Slowlybomb/T4-GroupProject/report/Gondalier_report.md

<script>
MathJax = { tex: { inlineMath: [['$','$']] } };
</script>
<script src="https://cdn.jsdelivr.net/npm/mathjax@3/es5/tex-chtml.js"></script>

# Gondolier
An Open Source Rowing Monitor
#### Group 4

Gondolier Logo

#### Group Members
- Hugo Guenebaut
- Emin Aksoyg
- Nixie
- Hleb Slyusar
- David Fresno
- Mark Cannavan

**Preface**

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

**Summary**

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

**History and Motivation**

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

**Context and Goals**

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

**System Overview**

At a high level Gondolier consists of:

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

**Architecture and Components**

This section describes components and their responsibilities, and how they interact.

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

2. Firmware (high level)

The firmware organizes functionality into modules:

- `accelerometer.h` \- handles IMU initialization, configuration and provides a ring buffer of recent acceleration samples.  
- `model.h` / `model_data.h` \- contain the TensorFlow Lite Micro model and inference integration code.  
- `Display.h` \- UI primitives for the on-boat display: main screen, metric updates, and minimal menus.  
- `networking.h` \- BLE advertisement, GATT services, and a simple protocol to upload sessions to the phone app.  
- `embedded-code.ino` \- application entrypoint, task orchestration, and state machine for session lifecycle.  
    
3. Machine learning model  
   The stroke detection model is trained offline on labeled IMU windows and exported to TFLite (`model.tflite`). At runtime we run a fixed-length sliding window of accelerometer magnitude through the TFLite Micro interpreter. The model outputs a probability (stroke / not-stroke) and the firmware applies a detection algorithm (threshold \+ debounce) to produce discrete stroke events.  

**Electronic Assembly:**

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

Simplified Schematic of the rowing tracker  
Simplified schematic of the rowing tracker

Breakout image of the electronics:

Image of the full electronics stack:  
**Design Decisions and Trade-offs**

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

**Obtaining Training Data**

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

Unprocessed z axis accelerometer data  
Unprocessed z axis accelerometer data
Because we knew that rowers would want to tilt the device at different angles so they could view the screen in boats with different designs, we had to process the data in a way that would be totally agnostic to device orientation. To achieve this, we used simple trigonometry. Obtaining the magnitude of the Y and Z axes, where the data is present, turned it into a vector of acceleration that would not change depending on orientation. 

$$
\vec{v} = \sqrt{Y^2 + Z^2}
$$

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

Noise signal before rolling average  
Noise signal before rolling average
Blue line inside orange shows the processed signal compared to orange noisy signal  
Blue line inside orange shows the processed signal compared to orange noisy signal
Lastly to remove gravitation anomalies, another rolling average was done but with a sample window size of 500, this acted as a high pass filter allowing the stroke data to pass through but not changes in the tilt of the boat

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

30 seconds of processed data showing 9 strokes  
30 seconds of processed data showing 9 strokes

- Creating stroke and non stroke training windows: Now that the data is cleaned and processed we had to decide how to best package the data to feed into the neural network, we tried a variety of methods for this, where we struggled was finding non stroke data, typically once on the water, Sally will row stroke after stroke until she is done with little rest time so to get non stroke data is very difficult, i created a python script that looked for peaks over a certain height, it labelled these peaks and then created windows across the whole dataset, overlapping with an offset of 1 second, the % of the stroke in each window was labelled based on where in the stroke the spike occurred and then a graph of each stroke was presented by the code to be manually approved or rejected, all windows that had less than 70% of a stroke as labelled as not a stroke. In the end, 400 windows were given to the model to train on, 300 stroke windows and 100 non stroke windows. This was a smaller dataset than we had wanted to work on but it still functioned well. This was the 8th different way we tried to window the data, it was difficult and involved a lot of trial and error and any attempt to use AI on this task threw us awry as this has never been attempted before publicly so there is no data online  

  Manual review of stroke data  
Manual review of stroke data
  Automated review of stroke data of entire 40 rowing session  
Automated review of stroke data of entire 40 rowing session

**Data Flow and Algorithms**

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

5. Event generation

6. Sync: When a session is complete, the user can request the session over 
   bluetooth, and the device will stream metadata and stroke timestamps to the phone app for storage and analysis.

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

2. Connection: The client connects and performs the GATT discovery process

3. Requests: The client writes `GET_SESSION` to the command characteristic

4. Data Transfer: The device sets status to `SENDING` and notifies packets 
   on the data characteristic

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

6. On a disconnect, the device resumes advertising automatically

Time Diagram of a typical Gondolier BLE Connection

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

A single custom service is exposed:

| Service UUID | 12345678-1234-1234-1234-123456789abc |
|---|---|

And three characteristics can be found in the GATT profile:

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

Structure of a data packet

**Firmware Structure and Files**

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

Build, Flashing, and Development

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

**Development Tips**

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

**Testing and Evaluation**

Unit testing on-device is limited, but key techniques used:

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

**Performance and Resource Usage**

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

**Security, Privacy, and Safety**

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

**Future Work and Open Questions**

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

**Appendix A \- File map and responsibilities**

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

**Appendix B \- How stroke detection works (algorithm)**

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

**Appendix C \- Contributors and references**

Contributors:

- Hugo Guenebaut \- Embedded systems lead  
- Emin Aksoy \- Machine learning engineer   
- Nixie \- Embedded UI designer  
- Mark \- Communications and radio engineer  
- 

References:

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
