Slowlybomb/T4-GroupProject/report/Gondalier_report.html

# Gondolier

An Open Source Rowing Monitor

## Group 4

Project Logo Gondolier Logo

### Group Members

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

## Preface

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

### Summary

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

### History and Motivation

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

### Context and Goals

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

### System Overview

At a high level Gondolier consists of:

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

## Architecture and Components

This section describes components and their responsibilities, and how they interact.

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

The firmware organizes functionality into modules:

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

### Electronic Assembly:

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

Simplified Schematic of the rowing tracker
Simplified schematic of the rowing tracker

Breakout image of the electronics:

Image of the full electronics stack:

### Design Decisions and Trade-offs

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

### Obtaining Training Data

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

Unprocessed z axis accelerometer data
Unprocessed z axis accelerometer data Because we knew that rowers would want to tilt the device at different angles so they could view the screen in boats with different designs, we had to process the data in a way that would be totally agnostic to device orientation. To achieve this, we used simple trigonometry. Obtaining the magnitude of the Y and Z axes, where the data is present, turned it into a vector of acceleration that would not change depending on orientation.

$$ \vec{v} = \sqrt{Y^2 + Z^2} $$

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

Noise signal before rolling average
Noise signal before rolling average

Blue line inside orange shows the processed signal compared to orange noisy signal
Blue line inside orange shows the processed signal compared to orange noisy signal

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

30 seconds of processed data showing 9 strokes
30 seconds of processed data showing 9 strokes

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

Manual review of stroke data
Manual review of stroke data

Automated review of stroke data of entire 40 rowing session
Automated review of stroke data of entire 40 rowing session

### Data Flow and Algorithms

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

#### Firmware Structure and Files

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

### Build, Flashing, and Development

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

#### Development Tips

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

#### Testing and Evaluation

Unit testing on-device is limited, but key techniques used:

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

#### Performance and Resource Usage

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

#### Security, Privacy, and Safety**

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

### Future Work and Open Questions

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

## Display

### Technical Specification

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

### Design Choices

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

Initial Display UI Prototype After review and feedback, this screen layout proved suboptimal. The most important piece of information on the screen for a rower will be the strokes per minute. Even though it is displayed as the biggest element, it still might not be clear enough for the number to be glanced at from a distance, or if the screen gets wet. Additionally, the font chosen proved not legible enough, especially since the same font was used for the text and the numbers. This led to many rough pixelated edges, making it harder to see the information needed.

The final UI screen builds upon the feedback received in all aspects.

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

Final Iteration of Display UI

### Tools, Functions and Workflow

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

Physical access to the board was limited, so to test out the UI, the code, and to ensure everything displayed properly, an esp32 emulator website wokwi.com was used. This website allowed us to work in parallel and then sync our work together using git.

Final Iteration of Display UI

### UI and Logo

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

Final Iteration of Display UI

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

## API, Database and CI/CD

### Preface

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

Decision and trade-off. we kept this subsystem focused on the implemented MVP rather than a larger platform design. That gave us a small and understandable backend surface that supported the app and report requirements without spending project time on infrastructure we did not need to demo.

### System Architecture

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

Architecture figure: Architecture figure

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

Decision and trade-off. This architecture deliberately prefers managed services over a fully self-hosted stack. The trade-off is less control over every layer, but in return we gained faster delivery, simpler environment setup, and tighter integration between auth, storage, and database security.

### API Design and Implementation

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

Decision and trade-off. I chose explicit handler validation and small repository methods instead of a more abstract service stack. The code is more repetitive, but every route's behaviour, validation rule, and failure mode is easy to trace, which was a better fit for a project that needed clarity more than abstraction.

### Authentication, Authorization, and Storage Security

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

Decision and trade-off. Manual JWKS verification required more code than using a shared secret or opaque auth proxy, but it kept the API independent, avoided storing a JWT signing secret in the service, and made the trust boundary explicit. The trade-off is that security logic has to be implemented carefully, which is why both middleware checks and database policies were used.

### Database Schema and Migration Decisions

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

The migration history shows how the schema evolved with the product:

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

Current database version: 5

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

Decision and trade-off. I chose a strongly constrained relational schema instead of storing most app state in loosely structured JSON documents. That makes migrations and schema changes more deliberate, but it gives clearer integrity guarantees and far simpler query logic for feeds, follows, and derived workout summaries.

### Database Automation and Derived Metrics

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

Decision and trade-off. Database-side derivation makes reads simpler and keeps client-visible workout values consistent, but it pushes more logic into migrations and trigger functions. I accepted that trade-off because the calculations are tightly coupled to persisted rowing data and are safer when enforced centrally rather than duplicated across clients.

### CI/CD, Deployment, and Local Development

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

Decision and trade-off. I prioritised a small operational surface: one Makefile, GitHub Actions for validation, and a deploy hook for release. The trade-off is that the deployment process is not a sophisticated release pipeline, but it is easy to understand, easy to troubleshoot, and appropriate for an MVP and demonstration environment.

### Testing, Trade-offs, and Future Work

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

Decision and trade-off. I treated testing and delivery as part of the product rather than as cleanup work at the end. The trade-off is that some future-facing features remain only partially integrated, but the implemented backend behaviour is better specified, better tested, and easier for another engineer to continue from.

## Appendixes

### Appendix A - File map and responsibilities

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

### Appendix B - How stroke detection works (algorithm)

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

### Appendix C - Contributors and references

Contributors:

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

### Appendix D - Backend file map and responsibilities

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

### Appendix E - Implemented API route reference

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

### Appendix F - Database migration map

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

### Appendix G - Operations and CI/CD quick reference

Make targets:

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

Environment variables:

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

Workflow summary:

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

### References

- TensorFlow Lite Micro documentation - https://www.tensorflow.org/lite/micro
- ESP32-S3 datasheet - https://documentation.espressif.com/esp32-s3_datasheet_en.pdf
- QMI8658 datasheet - https://qstcorp.com/upload/pdf/202202/QMI8658C%20datasheet%20rev%200.9.pdf
- ILI9431 datasheet - https://cdn-shop.adafruit.com/datasheets/ILI9341.pdf
