Slowlybomb/T4-GroupProject/app/flutter_app/assets/img/dummy-pp.png

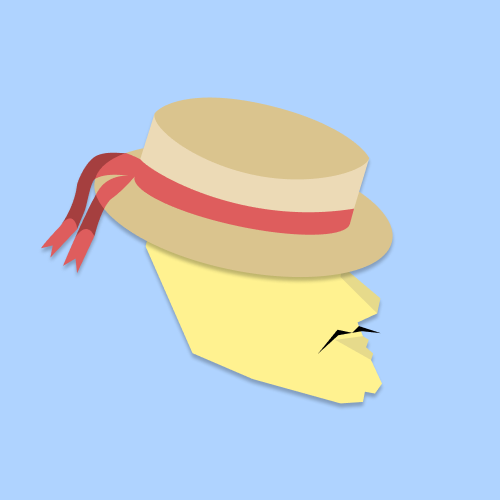
app/flutter_app/assets/img/dummy-pp.png
