Slowlybomb/T4-GroupProject/report/post.jpg

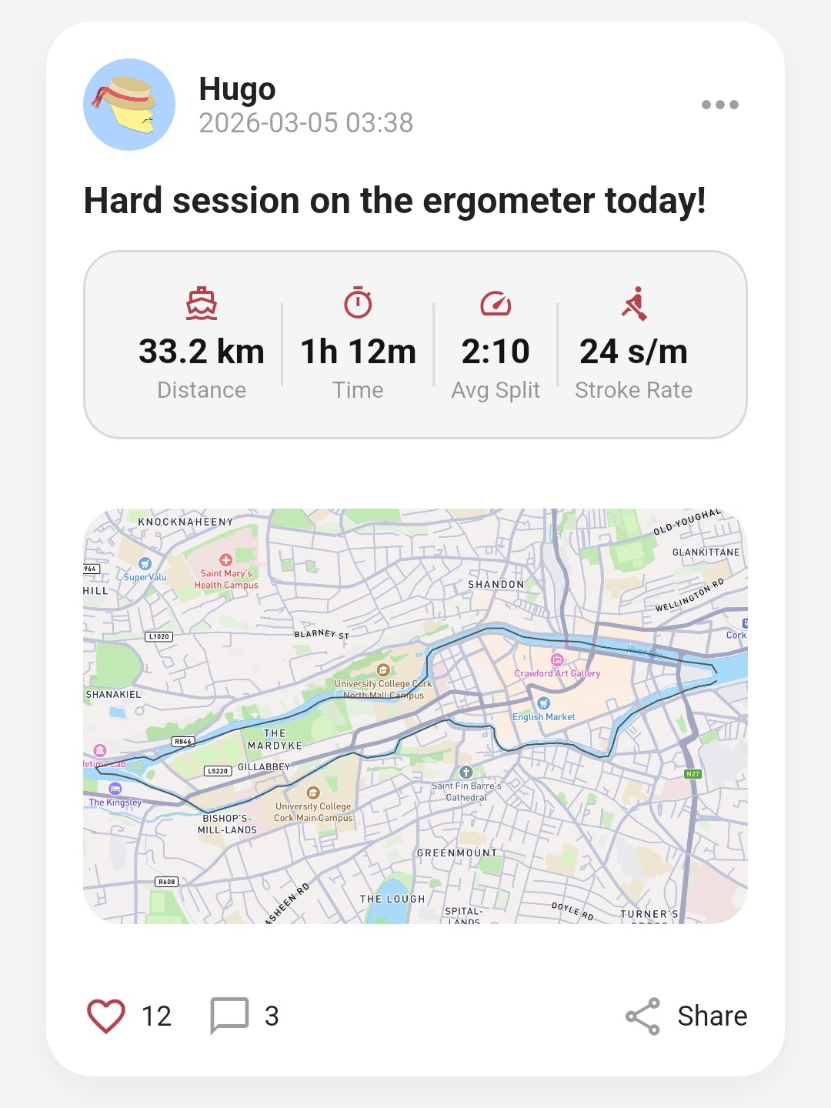
report/post.jpg
