Slowlybomb/T4-GroupProject/report/profile.jpg

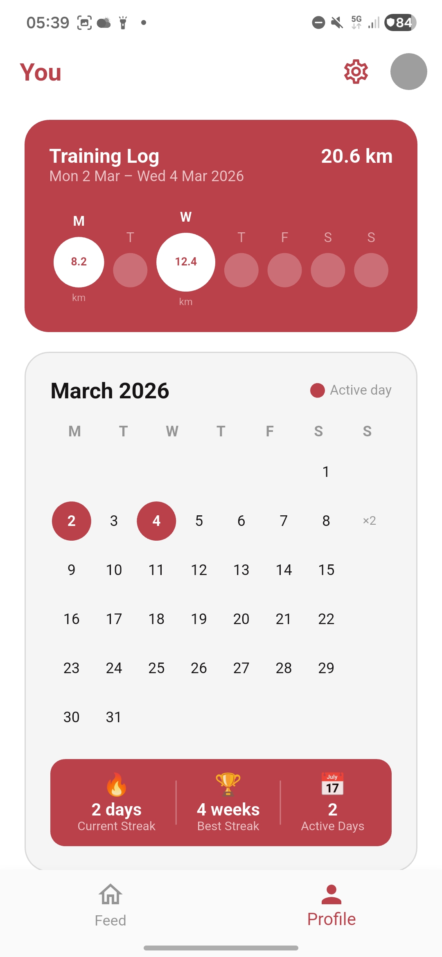
report/profile.jpg
