Slowlybomb/T4-GroupProject/report/t4_time_diagram.png

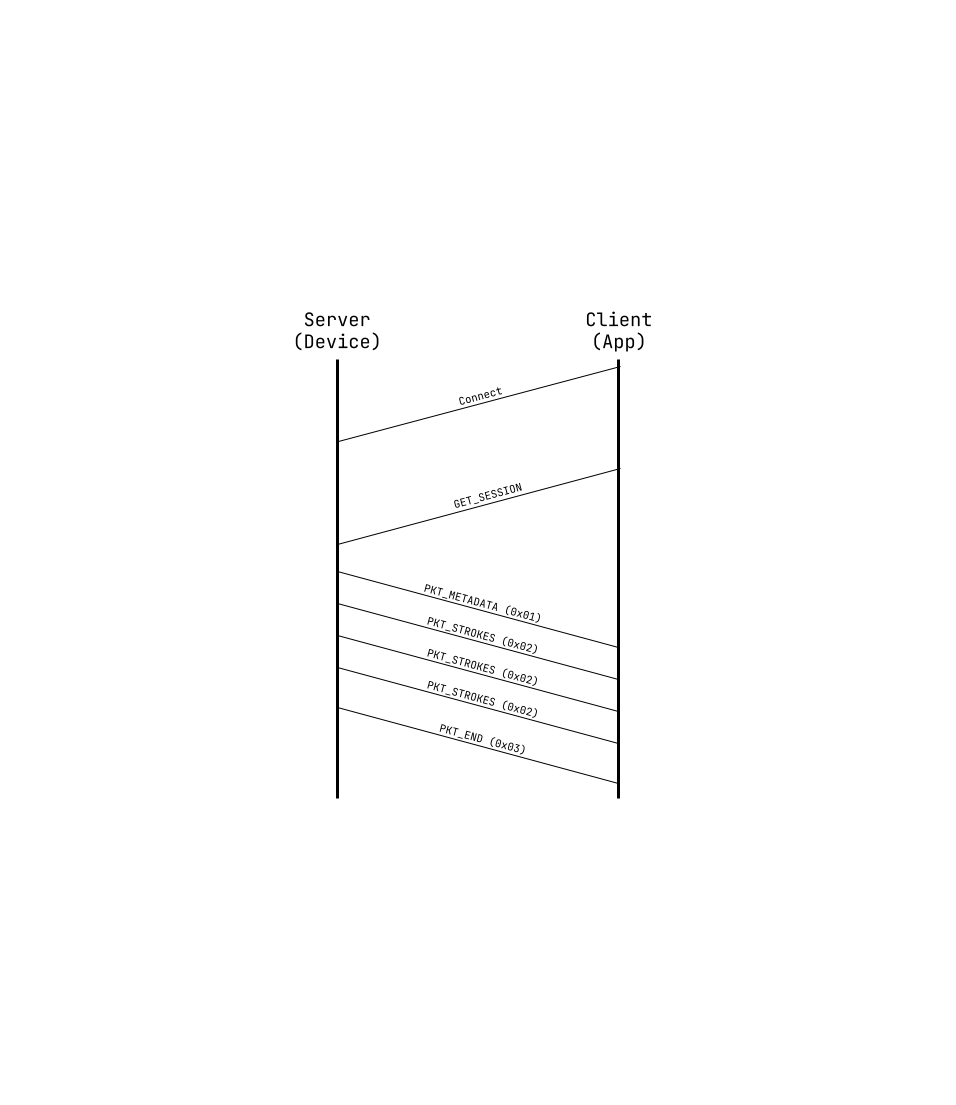
report/t4_time_diagram.png
