Slowlybomb/T4-GroupProject/Embedded_code/embedded-code/Display.h

// ILI9341 display and Gondolier rowing UI
//
// controlls the MCU UI, updates screen, initiates screen and sends split, elapsed and spm data to the screen for rendering

#pragma once
#include <Adafruit_ILI9341.h>
#include <Adafruit_GFX.h>
#include <Fonts/Org_01.h>

// Pins
#define TFT_CS    14
#define TFT_DC    18
#define TFT_RST   8
#define TFT_MOSI  11
#define TFT_CLK   12
//#define TFT_MISO  19
#define TFT_BL    17


// Colours 
#define C_WHITE  0xFFFF
#define C_BLACK  0x0000
#define C_GREEN  0x07E0
#define C_RED    0xF800
#define C_BLUE   0x001F

//Icon bitmaps
#ifndef ICONS_H
#define ICONS_H

// 24x13 battery icon
static const unsigned char image_battery_full_bits[] PROGMEM = {
  0xFF, 0xFF, 0xFF, 0x80, 0x00, 0x01, 0x80, 0x00, 0x01, 0x9F, 0xFF, 0xE1,
  0x9F, 0xFF, 0xE1, 0x9F, 0xFF, 0xE1, 0x9F, 0xFF, 0xE1, 0x9F, 0xFF, 0xE1,
  0x9F, 0xFF, 0xE1, 0x9F, 0xFF, 0xE1, 0x80, 0x00, 0x01, 0x80, 0x00, 0x01,
  0xFF, 0xFF, 0xFF
};

// 19x16 wifi icon
static const unsigned char image_wifi_bits[] PROGMEM = {
  0x07, 0xC0, 0x00, 0x1F, 0xF0, 0x00, 0x7C, 0x3C, 0x00, 0xF0, 0x0F, 0x00,
  0xC3, 0xC3, 0x00, 0x0F, 0xF0, 0x00, 0x3C, 0x3C, 0x00, 0x00, 0x00, 0x00,
  0x07, 0xE0, 0x00, 0x1F, 0xF8, 0x00, 0x18, 0x18, 0x00, 0x00, 0x00, 0x00,
  0x01, 0x80, 0x00, 0x01, 0x80, 0x00, 0x00, 0x00, 0x00, 0x00, 0x00, 0x00
};

static const unsigned char PROGMEM image_gondolier_icon_bits[] = {0x00,0x00,0x00,0x00,0x00,0x00,0x00,0x00,0x00,0x00,0x00,0x00,0x00,0x00,0x00,0x00,0x00,0x00,0x00,0x00,0x00,0x00,0x00,0x00,0x00,0x00,0x00,0x00,0x00,0x00,0x00,0x00,0x00,0x00,0x00,0x00,0x00,0x00,0x00,0x00,0x00,0x00,0x00,0x00,0x00,0x00,0x00,0x00,0x00,0x00,0x00,0x00,0x00,0x00,0x00,0x00,0x00,0x00,0x00,0x00,0x00,0x00,0x00,0x00,0x00,0x00,0x00,0x00,0x00,0x00,0x00,0x00,0x00,0x00,0x00,0x00,0x00,0x00,0x00,0x00,0x00,0x00,0x00,0x00,0x00,0x00,0x00,0x00,0x00,0x00,0x00,0x00,0x00,0x00,0x00,0x00,0x00,0x00,0x00,0x00,0x00,0x00,0x00,0x00,0x00,0x00,0x00,0x00,0x00,0x00,0x00,0x00,0x00,0x00,0x00,0x00,0x00,0x00,0x00,0x00,0x00,0x00,0x00,0x00,0x00,0x00,0x00,0x00,0x00,0x00,0x00,0x00,0x00,0x00,0x00,0x00,0x00,0x00,0x00,0x00,0x00,0x00,0x00,0x00,0x00,0x00,0x00,0x00,0x00,0x00,0x00,0x00,0x00,0x00,0x00,0x00,0x00,0x00,0x00,0x00,0x00,0x00,0x00,0x00,0x00,0x00,0x00,0x00,0x00,0x00,0x00,0x00,0x00,0x00,0x00,0x00,0x00,0x00,0x00,0x00,0x00,0x00,0x00,0x00,0x00,0x00,0x00,0x00,0x00,0x00,0x00,0x00,0x00,0x00,0x00,0x00,0x00,0x00,0x00,0x00,0x00,0x00,0x00,0x00,0x00,0x00,0x00,0x00,0x00,0x00,0x00,0x00,0x00,0x00,0x00,0x00,0x00,0x00,0x00,0x00,0x00,0x00,0x00,0x00,0x00,0x00,0x00,0x00,0x00,0x00,0x00,0x00,0x00,0x00,0x00,0x00,0x00,0x00,0x00,0x00,0x00,0x00,0x00,0x00,0x00,0x00,0x00,0x00,0x00,0x00,0x00,0x00,0x00,0x00,0x00,0x00,0x00,0x00,0x00,0x00,0x00,0x00,0x00,0x00,0x00,0x00,0x00,0x00,0x00,0x00,0x00,0x00,0x00,0x00,0x00,0x00,0x00,0x00,0x00,0x00,0x00,0x00,0x00,0x00,0x00,0x00,0x00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
,0x00,0x00,0x00,0x00,0x00,0x00,0x00,0x00,0x00,0x00,0x00,0x00,0x00,0x00,0x00,0x00,0x00,0x00,0x00,0x00,0x00,0x00,0x00,0x00,0x00,0x00,0x00,0x00,0x00,0x00,0x00,0x00,0x00,0x00,0x00,0x00,0x00,0x00,0x00,0x00,0x00,0x00,0x00,0x00,0x00,0x00,0x00,0x00,0x00,0x00,0x00,0x00,0x00,0x00,0x00,0x00,0x00,0x00,0x00,0x00,0x00,0x00,0x00,0x00,0x00,0x00,0x00,0x00,0x00,0x00,0x00,0x00,0x00,0x00,0x00,0x00,0x00,0x00,0x00,0x00,0x00,0x00,0x00,0x00,0x00,0x00,0x00,0x00,0x00,0x00,0x00,0x00,0x00,0x00,0x00,0x00,0x00,0x00,0x00,0x00,0x00,0x00,0x00,0x00,0x00,0x00,0x00,0x00,0x00,0x00,0x00,0x00,0x00,0x00,0x00,0x00,0x00,0x00,0x00,0x00,0x00,0x00,0x00,0x00,0x00,0x00,0x00,0x00,0x00,0x00,0x00,0x00,0x00};

#endif // ICONS_H

// Main UI
// initiate the full UI
void show_ui(Adafruit_ILI9341& tft) {
  tft.drawBitmap(290, 9, image_battery_full_bits, 24, 13, C_WHITE);
  tft.drawLine(1,   29,  319, 29,  C_WHITE);  // Header separator
  tft.drawLine(0,   169, 319, 169, C_WHITE);  // Stats separator
  tft.drawLine(0,   239, 318, 239, C_WHITE);  // Bottom border
  tft.drawLine(319, 0,   319, 239, C_WHITE);  // Right border
  tft.drawLine(0,   0,   319, 0,   C_WHITE);  // Top border
  tft.drawLine(0,   0,   0,   239, C_WHITE);  // Left border

  // Stroke count
  tft.setTextColor(C_WHITE);
  tft.setFont(&Org_01);
  tft.setTextSize(20);
  tft.setTextWrap(false);
  tft.setCursor(108, 126);
  tft.print("0");

  // Split time
  tft.setTextSize(4);
  tft.setCursor(22, 205);
  tft.print("0:00");

  // Strokes per minute
  tft.setFont(nullptr);
  tft.setTextSize(2);
  tft.setCursor(276, 150);
  tft.print("S/M");

  // Elapsed time
  tft.setFont(&Org_01);
  tft.setTextSize(3);
  tft.setCursor(186, 202);
  tft.print("00:00:00");

  // labels
  tft.setFont(nullptr);
  tft.setTextSize(2);
  tft.setCursor(218, 218);
  tft.print("Elapsed");
  tft.setCursor(23, 219);
  tft.print("split");

  // Header left — stroke rate
  tft.setFont(&Org_01);
  tft.setCursor(13, 20);
  tft.print("0:00");

  // WiFi icon
  tft.drawBitmap(258, 7, image_wifi_bits, 19, 16, C_WHITE);
}

// Splash screen

// Boot logo
void splashscreen(Adafruit_ILI9341& tft) {
  tft.fillScreen(C_BLACK);
  tft.drawBitmap(34, -40, image_gondolier_icon_bits, 262, 240, C_WHITE);
  tft.setTextColor(C_WHITE);
  tft.setFont(nullptr);
  tft.setTextSize(4);
  tft.setTextWrap(false);
  tft.setCursor(55, 203);
  tft.print("Gondolier");
}

// Live data updaters 

void update_timer(Adafruit_ILI9341& tft, const String& time) {
  tft.fillRect(186, 186, 130, 26, C_BLACK);
  tft.setFont(&Org_01);
  tft.setTextSize(3);
  tft.setCursor(186, 202);
  tft.print(time);
}

void update_split(Adafruit_ILI9341& tft, const String& split) {
  tft.fillRect(4, 186, 106, 26, C_BLACK);
  tft.setFont(&Org_01);
  tft.setTextSize(4);
  tft.setCursor(22, 205);
  tft.print(split);
}

// Centers the stroke count based on number of digits
void update_strokes(Adafruit_ILI9341& tft, const String& strokes) {
  tft.fillRect(44, 44, 240, 102, C_BLACK);
  tft.setTextColor(C_WHITE);
  tft.setFont(&Org_01);
  tft.setTextSize(20);

  int len = strokes.length();
  int cursorX = 108;

  if (len == 1) {
    cursorX = (strokes[0] == '1') ? 148 : 108;
  } else if (len == 2) {
    bool d0is1 = (strokes[0] == '1');
    bool d1is1 = (strokes[1] == '1');
    if (d0is1 && d1is1) cursorX = 124;
    else if (d0is1 || d1is1) cursorX = 84;
    else cursorX = 44;
  }

  tft.setCursor(cursorX, 126);
  tft.print(strokes);
}

// Updates strokes, split, and elapsed time together
void update_screen(Adafruit_ILI9341& tft,
                   const String& strokes,
                   const String& split,
                   const String& time) {
  update_strokes(tft, strokes);
  update_split(tft,   split);
  update_timer(tft,   time);
}

// Status overlays

void show_bluetooth_status(Adafruit_ILI9341& tft, bool connected) {
  tft.fillRect(230, 4, 22, 22, C_BLACK);
  tft.setFont(nullptr);
  tft.setTextSize(2);
  tft.setTextColor(connected ? C_GREEN : C_RED);
  tft.setCursor(232, 8);
  tft.print("BT");
}

// Green when connected, white when idle
void show_wifi_status(Adafruit_ILI9341& tft, bool connected) {
  tft.drawBitmap(258, 7, image_wifi_bits, 19, 16, connected ? C_GREEN : C_WHITE);
}

// Progress bar + "Sending data..." message
void show_transfer_progress(Adafruit_ILI9341& tft, int percent) {
  tft.fillRect(10, 80, 300, 40, C_BLACK);
  tft.setFont(nullptr);
  tft.setTextSize(2);
  tft.setTextColor(C_WHITE);
  tft.setCursor(100, 85);
  tft.print("Sending data...");
  // Progress bar
  tft.drawRect(10, 106, 300, 14, C_WHITE);
  int filled = (int)(300.0f * percent / 100.0f);
  tft.fillRect(10, 106, filled, 14, C_GREEN);
}

// Shows a message in the middle of the screen
void show_message(Adafruit_ILI9341& tft, const String& msg, uint16_t colour = C_WHITE) {
  tft.fillRect(10, 80, 300, 60, C_BLACK);
  tft.setFont(nullptr);
  tft.setTextSize(2);
  tft.setTextColor(colour);
  tft.setCursor(10, 100);
  tft.print(msg);
}

// formats time into "HH:MM:SS"
String formatElapsed(uint32_t seconds) {
  uint32_t h = seconds / 3600;
  uint32_t m = (seconds % 3600) / 60;
  uint32_t s = seconds % 60;
  char buf[12];
  snprintf(buf, sizeof(buf), "%02u:%02u:%02u", h, m, s);
  return String(buf);
}

// formats time into "M:SS" (e.g. 135 → "2:15")
String formatSplit(uint32_t splitSeconds) {
  uint32_t m = splitSeconds / 60;
  uint32_t s = splitSeconds % 60;
  char buf[8];
  snprintf(buf, sizeof(buf), "%u:%02u", m, s);
  return String(buf);
}
