Slowlybomb/T4-GroupProject/(commit log)

2026-02-16 feat: Add initial database schema migration files for Supabase
    - Created `000001_initial_schema.up.sql` for setting up the initial database schema including tables for profiles, teams, activities, follows, likes, and comments.
    - Created `000001_initial_schema.down.sql` for rolling back the initial schema.
    - Implemented row-level security policies for activities to manage visibility based on user authentication.
    - Added a trigger to ensure team owners are also members of their teams.
    docs: Update project documentation
    - Revised `App-Plan.md` to reflect the current tech stack and rationale.
    - Enhanced `Checklist.md` with completed tasks and additional details on JWT validation and user sessi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
2026-02-17 Add cache files for various Go modules and update build artifacts
    - Created new cache files for Go build artifacts in the app/api/.cache/go-build directory.
    - Added lock files for dependencies: gin-gonic/gin v1.11.0 and jackc/pgx v5.8.0.
    - Introduced a trim.txt file to track build timestamps.
    - Updated internal cache for godebugs and ecdsa packages.
2026-03-02 feat: implement authentication flow with deep-linking and Supabase integration
2026-03-03 feat: enhance user profile management and onboarding flow
    - Added demo account login functionality in onboarding screen.
    - Updated RowingApp to accept a custom logged-in home widget.
    - Implemented account details management in UserStatsScreen.
    - Introduced validation for account details update, including password confirmation.
    - Enhanced AuthRepository with current account details retrieval and update functionality.
2026-03-04 assets: sample rowing data
    [data_timestampts_distance.csv, data_timestampts_distance2.csv, data_timestampts_distance3.csv, data_timestampts_distance4.csv]
2026-03-04 feat(feed): enhance feed repository with new features and models
    - Updated FeedRepository to include methods for fetching follow suggestions, liking posts, and retrieving weekly summaries.
    - Implemented LocalFeedRepository to provide mock data for new features.
    - Introduced FeedScope enum for filtering feed views.
    - Added FollowSuggestion model to represent user follow suggestions.
    - Enhanced Post model to include comments and route points.
    - Created WeeklySummary model to summarize weekly activities.
    - Updated ActivityPostCard to display route previews and handle user interactions for liking, commenting, and sharing posts.
    - Refactored FilterTabs to utilize FeedScope for tab selection.
    - Im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
2026-03-04 Refactor FeedScreen to use FeedScope and improve state management
    - Changed FeedScreen from StatefulWidget to StatelessWidget.
    - Introduced FeedScope for better handling of feed categories.
    - Removed hardcoded "Your Posts" data and integrated WeeklySummaryCard.
    - Updated slivers in CustomScrollView to handle loading, error, and empty states more effectively.
    - Enhanced ActivityPostCard interactions with like, comment, and share functionalities.
    - Cleaned up unnecessary code and improved readability.
    Refactor ApiFeedRepository to streamline route point mapping
    - Simplified mapping of route coordinates to RoutePoint objects in ApiFeedRepository.
    Update ActivityPostCard and WeeklySummaryCard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
    [openapi.yaml]
